gadgets-on-github/solar-inverter/README.md

# solar-inverter
Open source solar micro-inverter by Martin van den Nieuwelaar.

See www.arduino42.com for the official blurb.
