gadgets-on-github/solar-inverter/schematic/readme.txt

This is not all of the schematics yet; more to come.  It is however perhaps the most interesting, including the boost converter and the actual inverter.
