gadgets-on-github/solar-inverter/schematic/inverter-v201.pdf

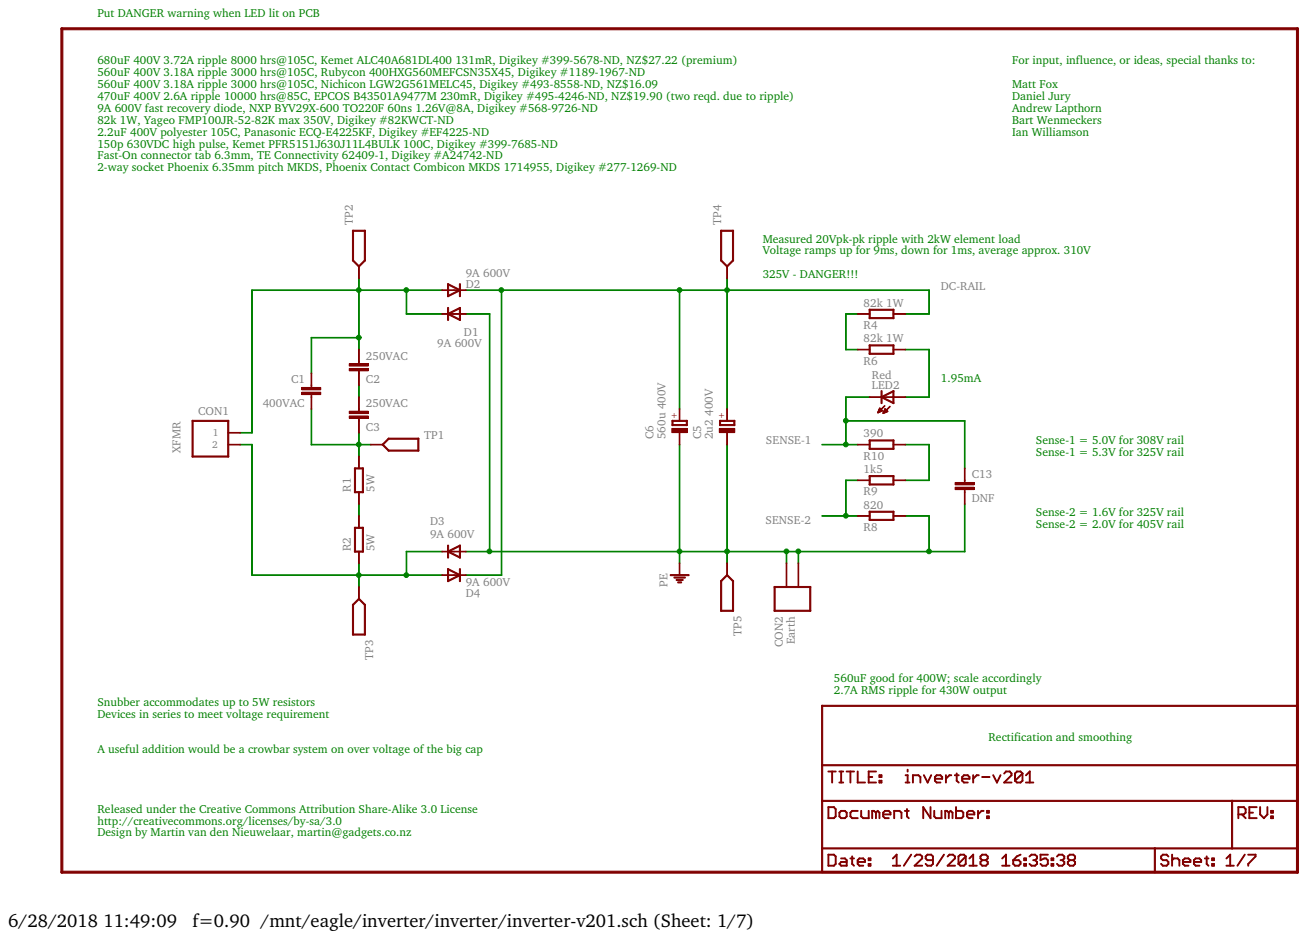
[picture p4: page 1]

Put DANGER warning when LED lit on PCB

680uF 400V 3.72A ripple 8000 hrs@105C, Kemet ALC40A681DL400 131mR, Digikey #399-5678-ND, NZ$27.22 (premium)
560uF 400V 3.18A ripple 3000 hrs@105C, Rubycon 400HXG560MEFCSN35X45, Digikey #1189-1967-ND
560uF 400V 3.18A ripple 3000 hrs@105C, Nichicon LGW2G561MELC45, Digikey #493-8558-ND, NZ$16.09
470uF 400V 2.6A ripple 10000 hrs@85C, EPCOS B43501A9477M 230mR, Digikey #495-4246-ND, NZ$19.90 (two reqd. due to ripple)
82k 1W, Yageo FMP100JR-52-82K max 350V, Digikey #82KWCT-ND
2.2uF 400V polyester 105C, Panasonic ECQ-E4225KF, Digikey #EF4225-ND
150p 630VDC high pulse, Kemet PFR5151J630J11L4BULK 100C, Digikey #399-7685-ND
Fast-On connector tab 6.3mm, TE Connectivity 62409-1, Digikey #A24742-ND
2-way socket Phoenix 6.35mm pitch MKDS, Phoenix Contact Combicon MKDS 1714955, Digikey #277-1269-ND

For input, influence, or ideas, special thanks to:

Measured 20Vpk-pk ripple with 2kW element load
Voltage ramps up for 9ms, down for 1ms, average approx. 310V

560uF good for 400W; scale accordingly
2.7A RMS ripple for 430W output

Snubber accommodates up to 5W resistors
Devices in series to meet voltage requirement

A useful addition would be a crowbar system on over voltage of the big cap

Released under the Creative Commons Attribution Share-Alike 3.0 License
http://creativecommons.org/licenses/by-sa/3.0
Design by Martin van den Nieuwelaar, martin@gadgets.co.nz

6/28/2018 11:49:09 f=0.90 /mnt/eagle/inverter/inverter/inverter-v201.sch (Sheet: 1/7)

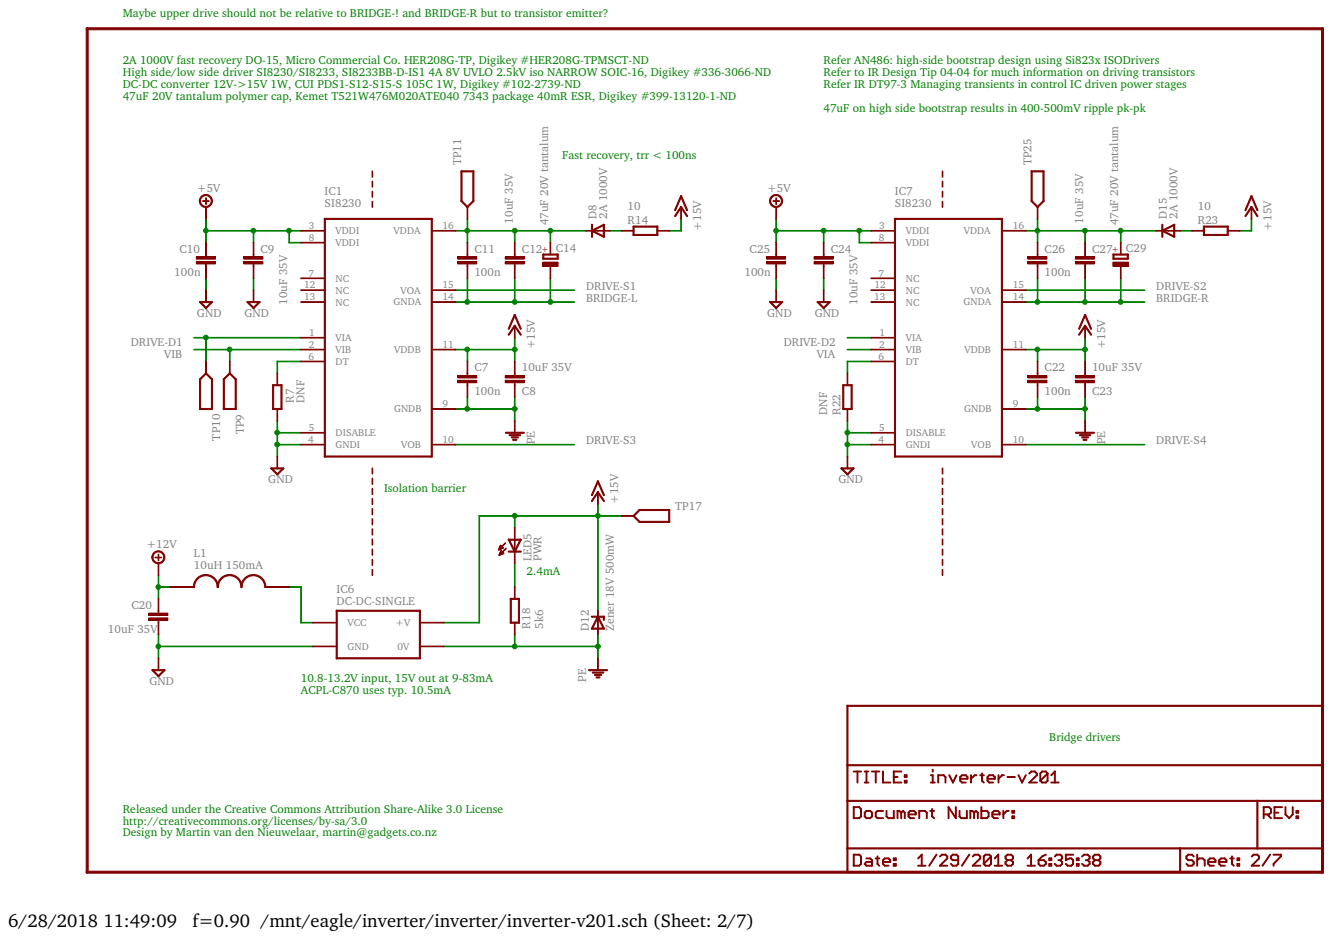
[picture p5: page 2]

Maybe upper drive should not be relative to BRIDGE-! and BRIDGE-R but to transistor emitter?

2A 1000V fast recovery DO-15, Micro Commercial Co. HER208G-TP, Digikey #HER208G-TPMSCT-ND
DC-DC converter 12V->15V 1W, CUI PDS1-S12-S15-S 105C 1W, Digikey #102-2739-ND
47uF 20V tantalum polymer cap, Kemet T521W476M020ATE040 7343 package 40mR ESR, Digikey #399-13120-1-ND

Refer AN486: high-side bootstrap design using Si823x ISODrivers

Refer IR DT97-3 Managing transients in control IC driven power stages

47uF on high side bootstrap results in 400-500mV ripple pk-pk

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

6/28/2018 11:49:09 f=0.90 /mnt/eagle/inverter/inverter/inverter-v201.sch (Sheet: 2/7)

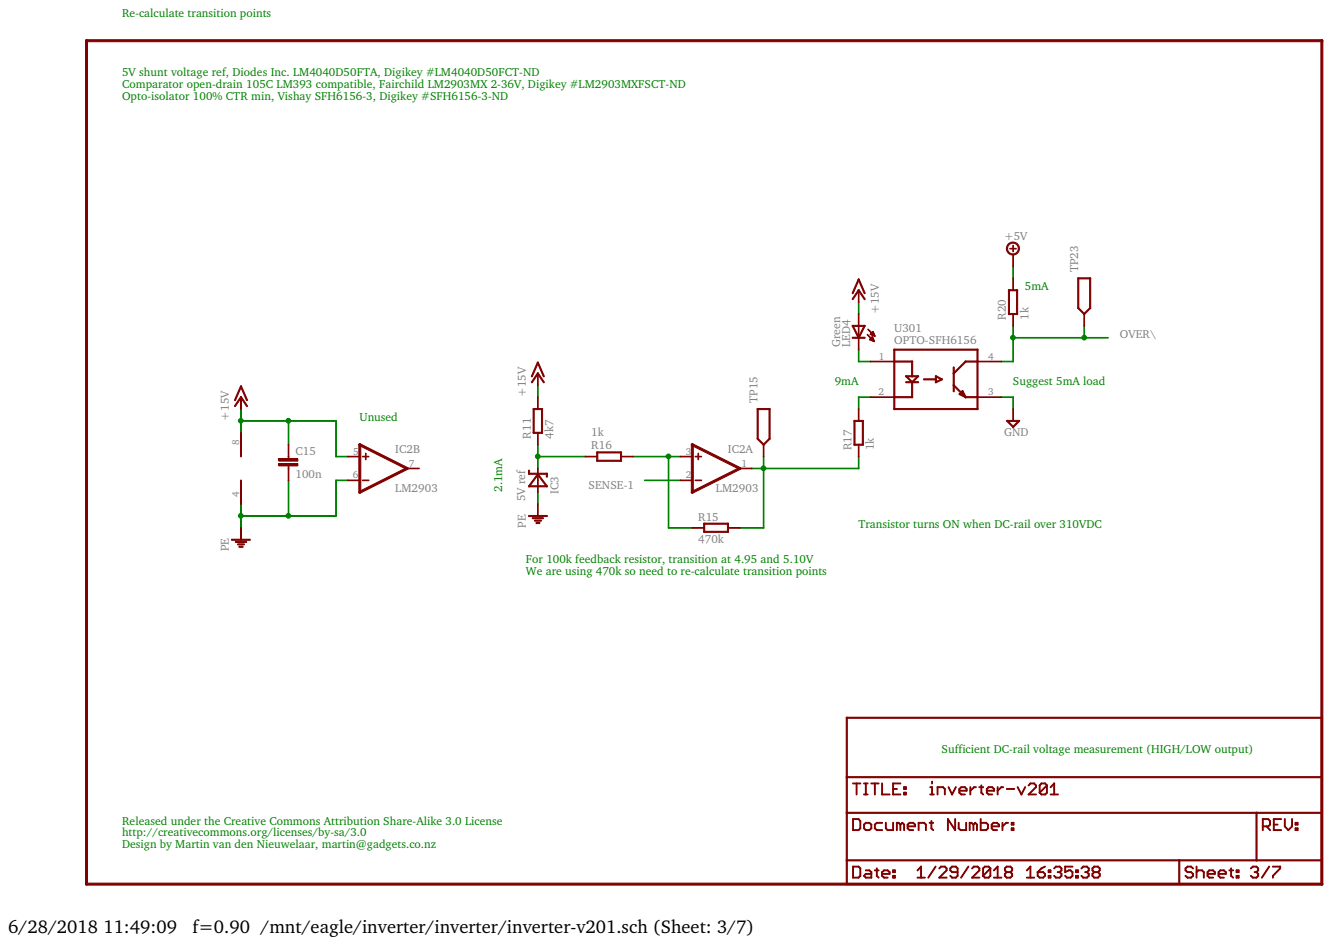
[picture p6: page 3]

Re-calculate transition points

5V shunt voltage ref, Diodes Inc. LM4040D50FTA, Digikey #LM4040D50FCT-ND
Comparator open-drain 105C LM393 compatible, Fairchild LM2903MX 2-36V, Digikey #LM2903MXFSCT-ND
Opto-isolator 100% CTR min, Vishay SFH6156-3, Digikey #SFH6156-3-ND

Transistor turns ON when DC-rail over 310VDC

For 100k feedback resistor, transition at 4.95 and 5.10V
We are using 470k so need to re-calculate transition points

Sufficient DC-rail voltage measurement (HIGH/LOW output)

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

6/28/2018 11:49:09 f=0.90 /mnt/eagle/inverter/inverter/inverter-v201.sch (Sheet: 3/7)

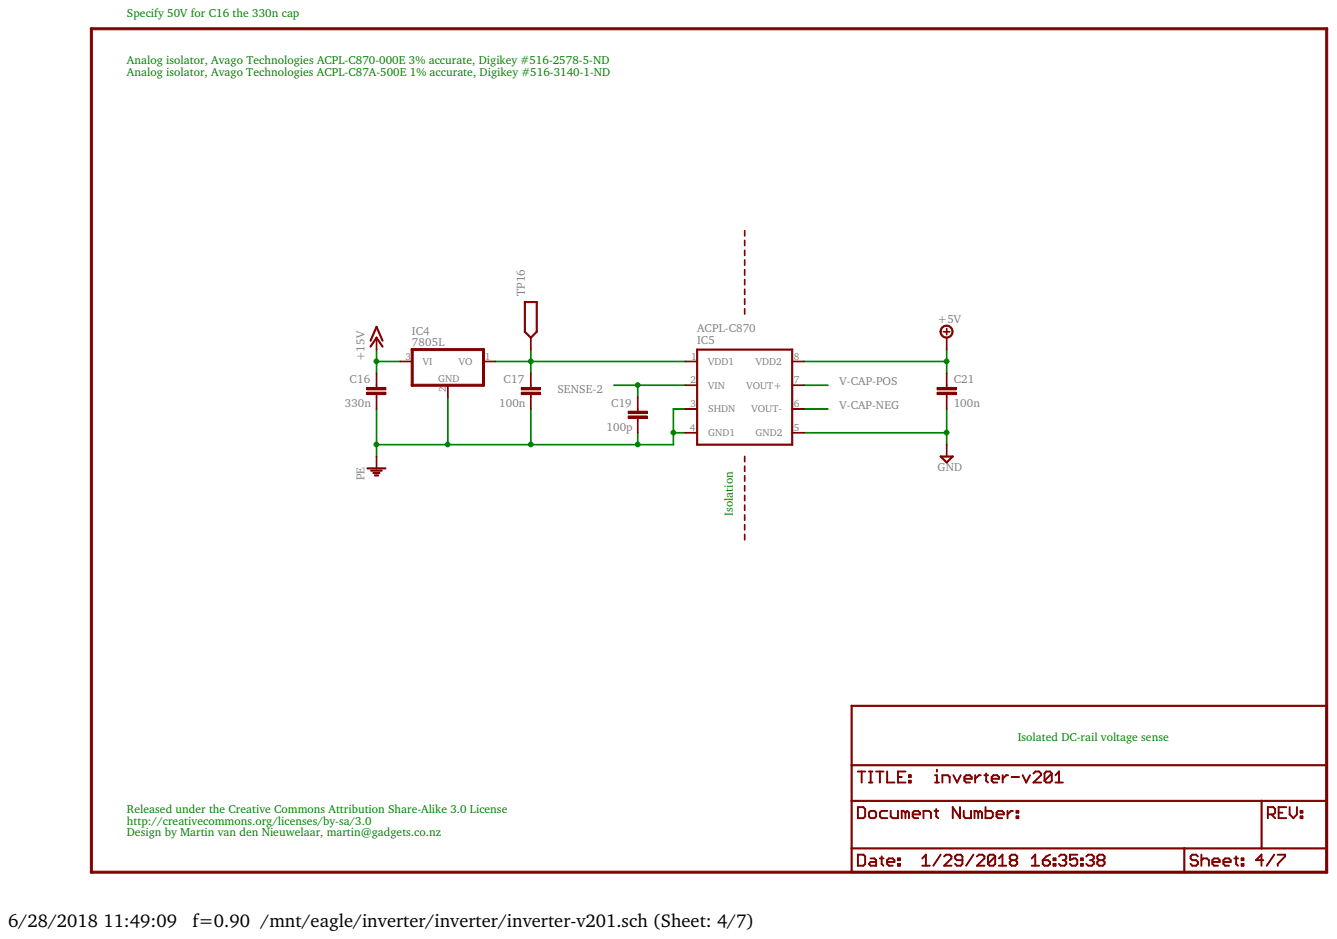
[picture p7: page 4]

Specify 50V for C16 the 330n cap

Analog isolator, Avago Technologies ACPL-C870-000E 3% accurate, Digikey #516-2578-5-ND
Analog isolator, Avago Technologies ACPL-C87A-500E 1% accurate, Digikey #516-3140-1-ND

Isolated DC-rail voltage sense

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

6/28/2018 11:49:09 f=0.90 /mnt/eagle/inverter/inverter/inverter-v201.sch (Sheet: 4/7)

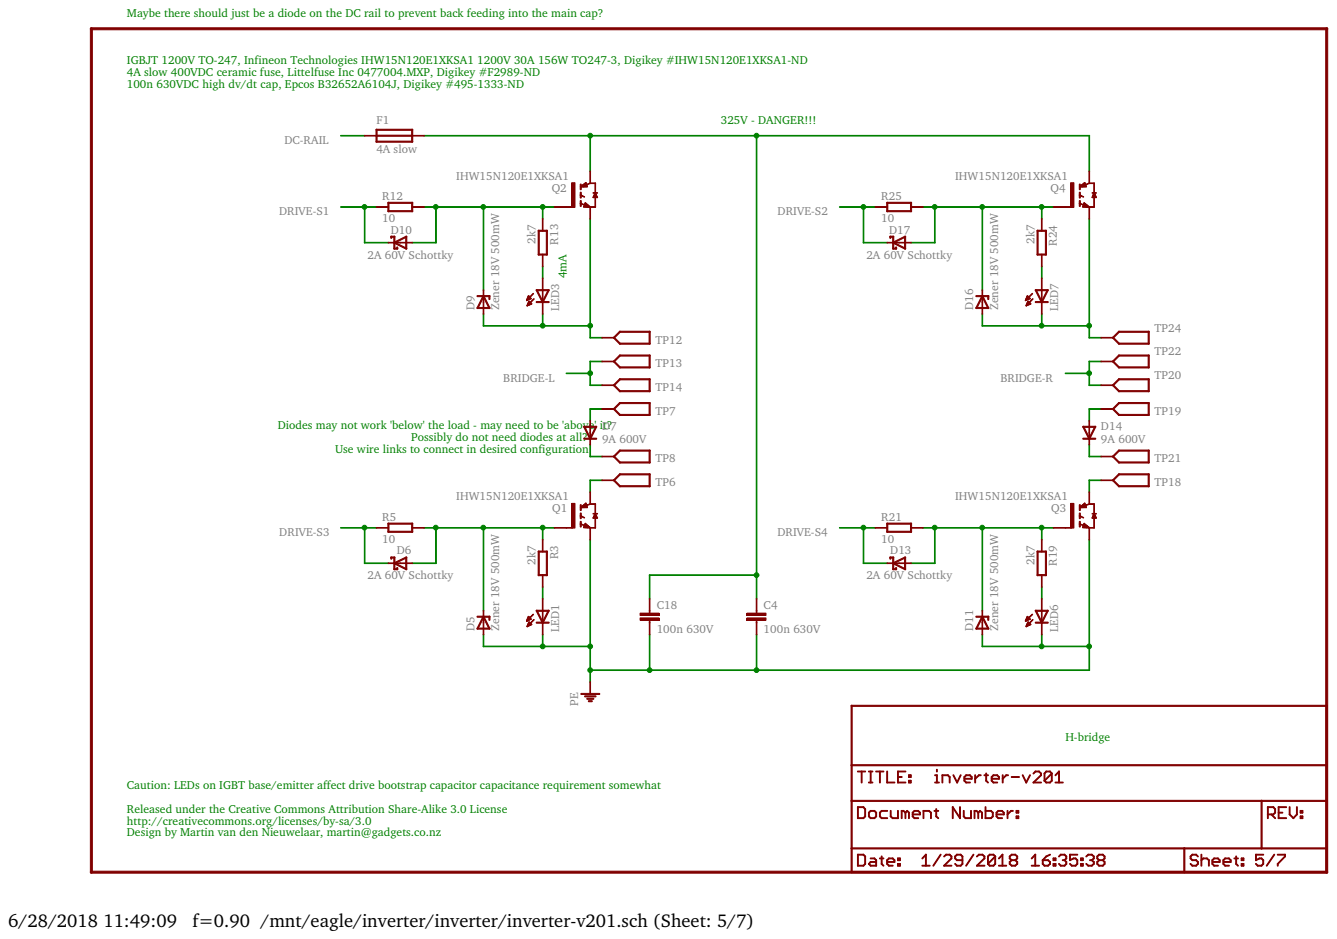
[picture p8: page 5]

Maybe there should just be a diode on the DC rail to prevent back feeding into the main cap?

IGBJT 1200V TO-247, Infineon Technologies IHW15N120E1XKSA1 1200V 30A 156W TO247-3, Digikey #IHW15N120E1XKSA1-ND
4A slow 400VDC ceramic fuse, Littelfuse Inc 0477004.MXP, Digikey #F2989-ND
100n 630VDC high dv/dt cap, Epcos B32652A6104J, Digikey #495-1333-ND

Diodes may not work 'below' the load - may need to be 'above' it?

Possibly do not need diodes at all?

Use wire links to connect in desired configuration

Caution: LEDs on IGBT base/emitter affect drive bootstrap capacitor capacitance requirement somewhat

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

6/28/2018 11:49:09 f=0.90 /mnt/eagle/inverter/inverter/inverter-v201.sch (Sheet: 5/7)

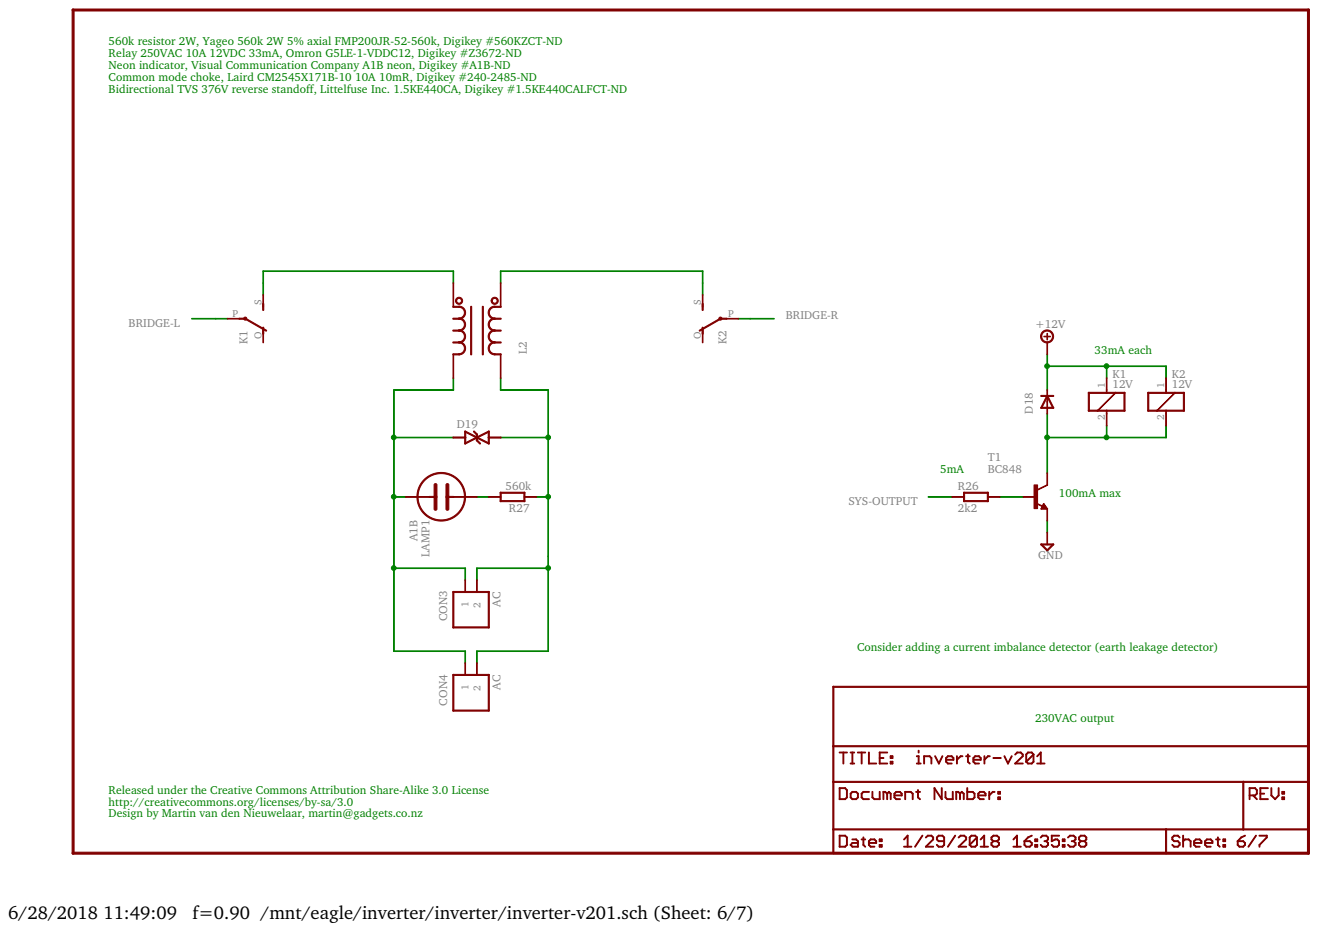
[picture p9: page 6]

560k resistor 2W, Yageo 560k 2W 5% axial FMP200JR-52-560k, Digikey #560KZCT-ND
Relay 250VAC 10A 12VDC 33mA, Omron G5LE-1-VDDC12, Digikey #Z3672-ND
Neon indicator, Visual Communication Company A1B neon, Digikey #A1B-ND
Common mode choke, Laird CM2545X171B-10 10A 10mR, Digikey #240-2485-ND
Bidirectional TVS 376V reverse standoff, Littelfuse Inc. 1.5KE440CA, Digikey #1.5KE440CALFCT-ND

Consider adding a current imbalance detector (earth leakage detector)

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

6/28/2018 11:49:09 f=0.90 /mnt/eagle/inverter/inverter/inverter-v201.sch (Sheet: 6/7)

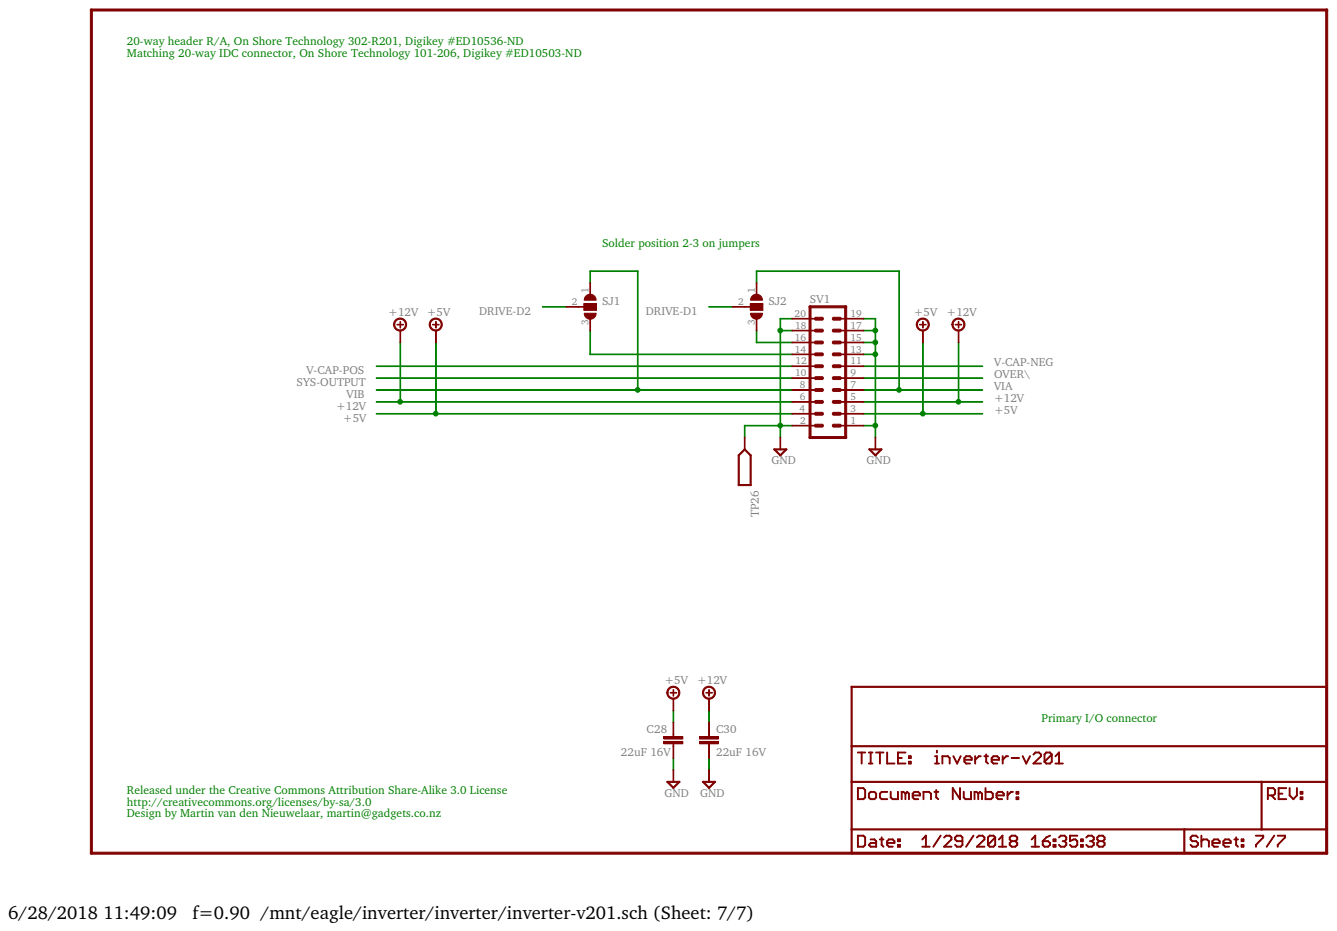
[picture p10: page 7]

20-way header R/A, On Shore Technology 302-R201, Digikey #ED10536-ND
Matching 20-way IDC connector, On Shore Technology 101-206, Digikey #ED10503-ND

Solder position 2-3 on jumpers

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

6/28/2018 11:49:09 f=0.90 /mnt/eagle/inverter/inverter/inverter-v201.sch (Sheet: 7/7)
