gadgets-on-github/solar-inverter/schematic/master-v100.pdf

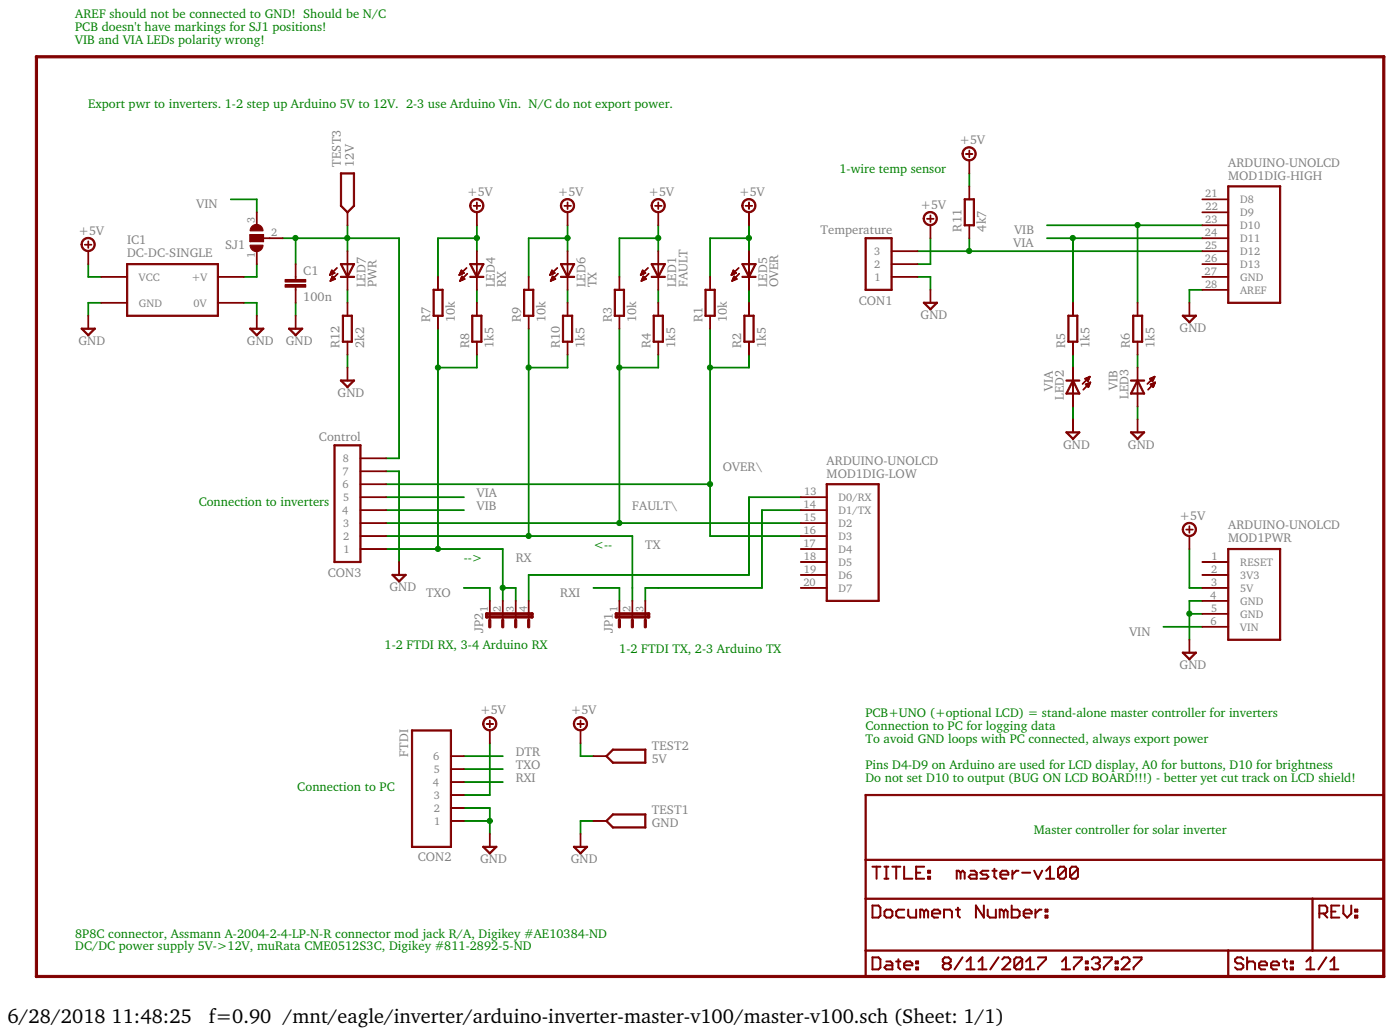
[picture p11: page 1]

AREF should not be connected to GND! Should be N/C
PCB doesn't have markings for SJ1 positions!
VIB and VIA LEDs polarity wrong!

Export pwr to inverters. 1-2 step up Arduino 5V to 12V. 2-3 use Arduino Vin. N/C do not export power.

1-2 FTDI RX, 3-4 Arduino RX

1-2 FTDI TX, 2-3 Arduino TX

PCB+UNO (+optional LCD) = stand-alone master controller for inverters
Connection to PC for logging data
To avoid GND loops with PC connected, always export power

Pins D4-D9 on Arduino are used for LCD display, A0 for buttons, D10 for brightness
Do not set D10 to output (BUG ON LCD BOARD!!!) - better yet cut track on LCD shield!

Master controller for solar inverter

8P8C connector, Assmann A-2004-2-4-LP-N-R connector mod jack R/A, Digikey #AE10384-ND
DC/DC power supply 5V->12V, muRata CME0512S3C, Digikey #811-2892-5-ND

6/28/2018 11:48:25 f=0.90 /mnt/eagle/inverter/arduino-inverter-master-v100/master-v100.sch (Sheet: 1/1)
